hydrastro/pyrilascon/(commit log)

2026-05-15 after cleanup
    [selected_valid_configs.csv]
2026-05-15 AXI + 4 rounds per stage
2026-05-15 split firmware + new board profiles
2026-05-15 boards, firmware etcgi
2026-05-15 behavioral simulation
    [selected_valid_configs.csv]
2026-05-16 expand multi beat AXI MMIO system simulation
    [selected_valid_configs.csv]
2026-05-16 Tang Nano NEORV32 stream board manifest
2026-05-16 NEORV32 stream board preflight
2026-05-16 NEORV UART bench
2026-05-16 NEORV32 stream board dry run plan
2026-05-16 neorv32 stream board session runner
2026-05-16 gowin handoff for NEORV32 stream board target
2026-05-16 im tired
2026-05-17 working on it
    [selected_valid_configs.csv]
2026-05-20 Cosim Makefile pre-filters CORE_SRC; parser survives UART noise
    - Filter neorv32_newlib.c out of CORE_SRC before invoking the firmware
    build: it drags newlib's libc.a (rv32imc/ilp32d multilib in nixpkgs)
    into the link, triggering the soft-vs-double-float linker conflict.
    - parse_neorv32_ascon_uart_log.py: decode with errors='replace' so a
    few bytes of UART boot-time line noise don't crash the parser.
    - New parse_sweep_log.py: dedicated parser for the CASE-line format,
    emits Markdown / JSON / LaTeX-table-rows.
